LeomorBE/3DController/Schematique/dimensions_teensylc.png

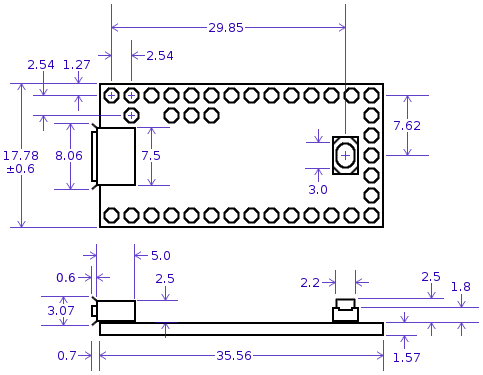
Schematique/dimensions_teensylc.png
