LeomorBE/3DController/Schematique/Proto/Proto-F_Cu.jpg

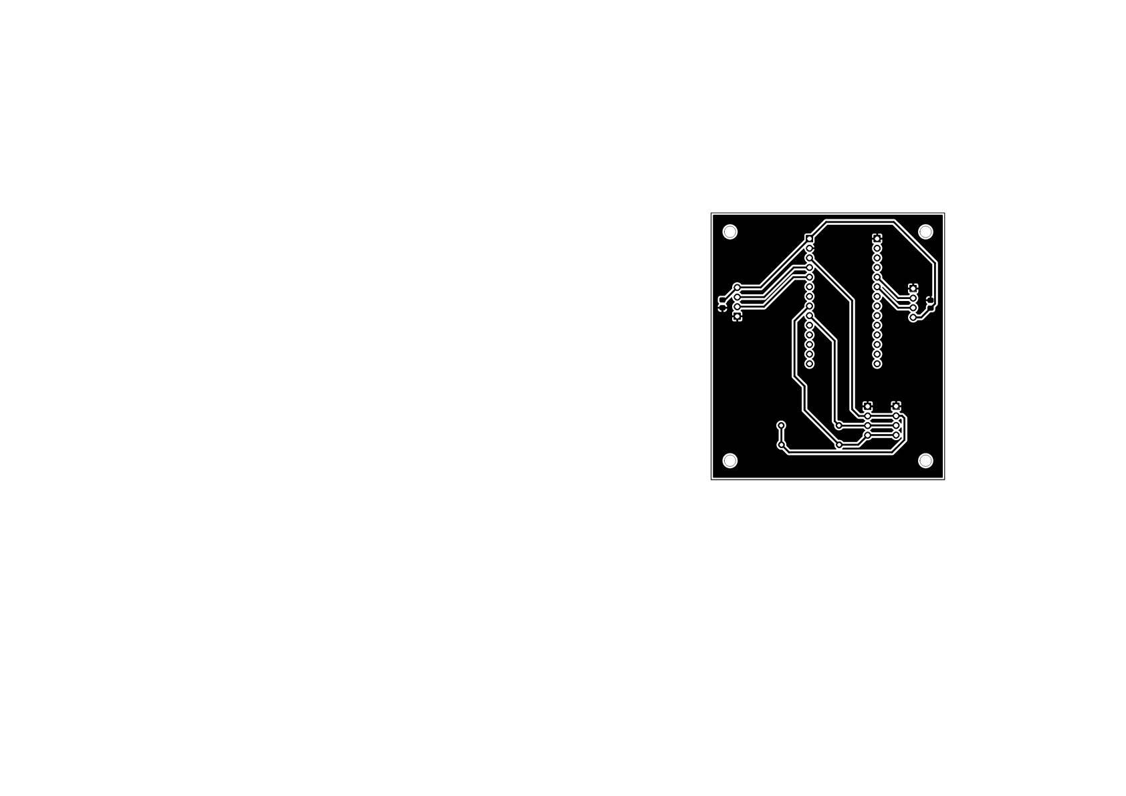
Schematique/Proto/Proto-F_Cu.jpg
