LeomorBE/3DController/manette.3mf

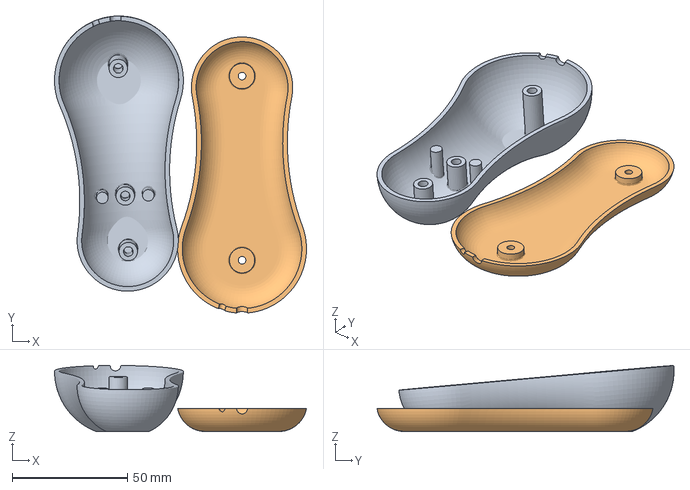
[picture p6: CAD file, 2026-11-09]
manette.3mf
109.5 x 129.0 x 28.7 mm
manette.stl
couvercle manette.stl
