LeomorBE/3DController/couvercle manette.stl

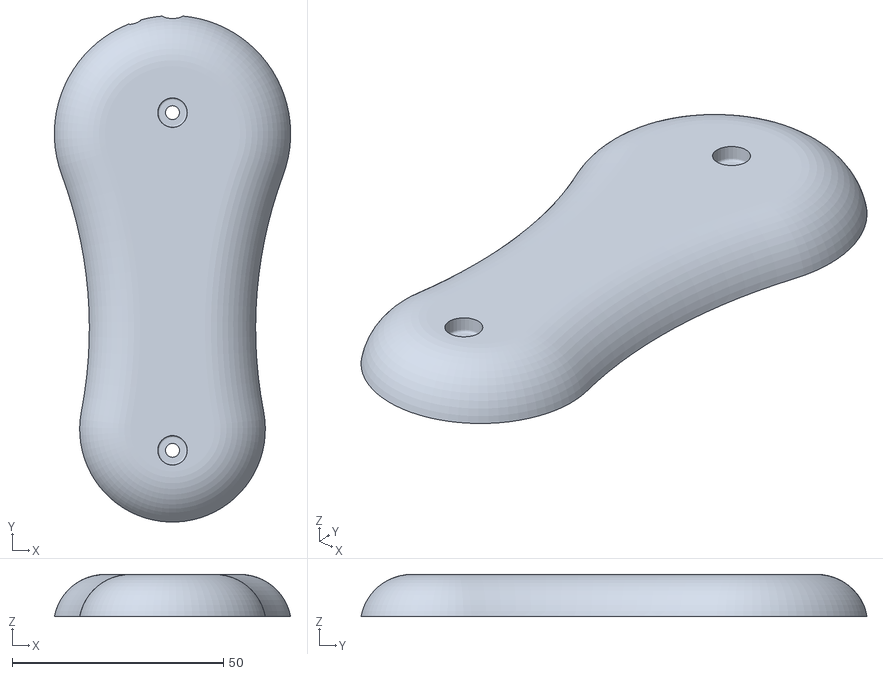
[picture p7: CAD file, 2026-11-09]
couvercle manette.stl
56.0 x 119.9 x 10.0
