LeomorBE/3DController/(list of files, cad)

Other CAD files:
manette.stl
