LeomorBE/3DController/Schematique/Proto/Proto-F_Cu.pdf

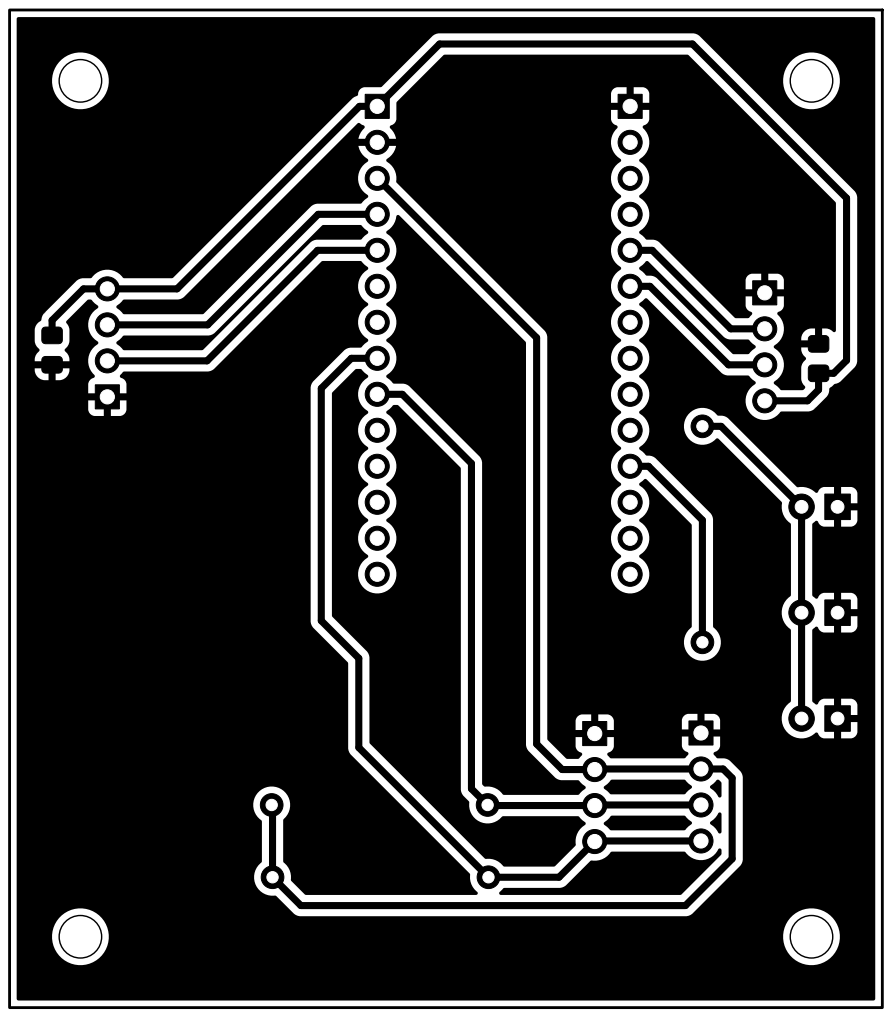
[picture p8: page 1]
