LeomorBE/3DController/Schematique/Proto/Proto-User_4.pdf

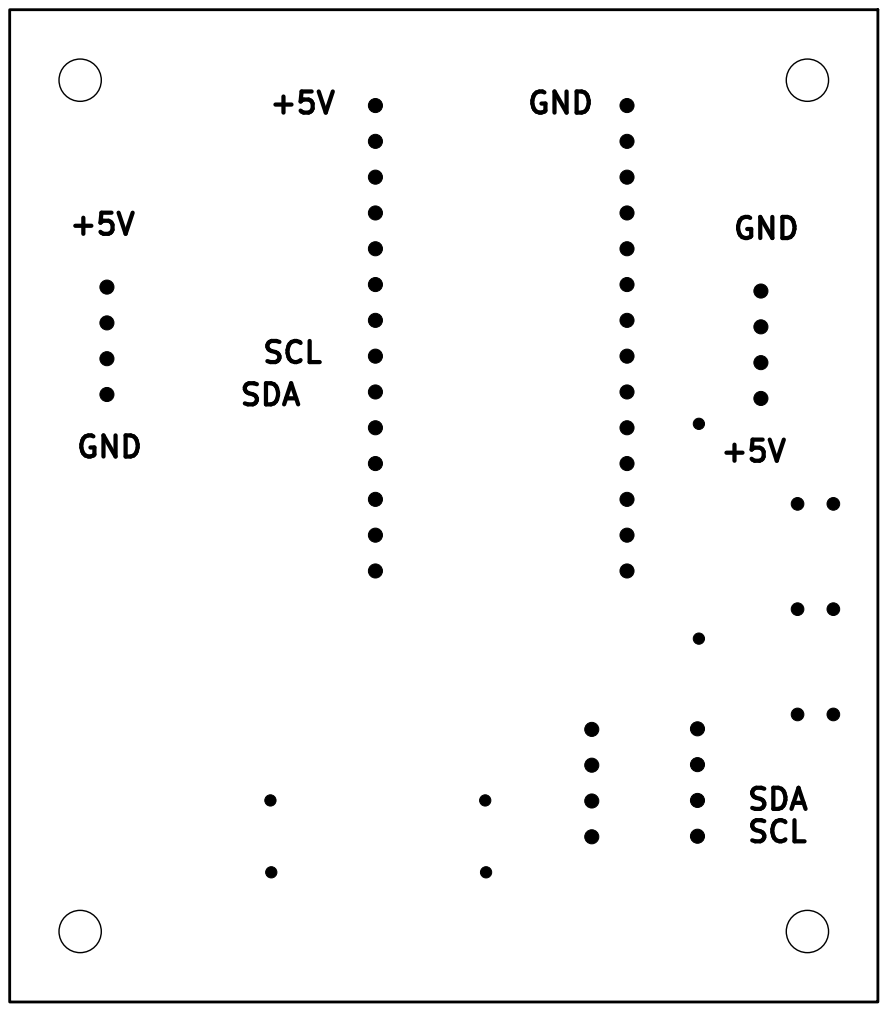
[picture p9: page 1]
