LeomorBE/3DController/Schematique/Proto/Proto.kicad_pcb

## KiCad design Schematique/Proto/Proto.kicad_pcb (2026-11-09)

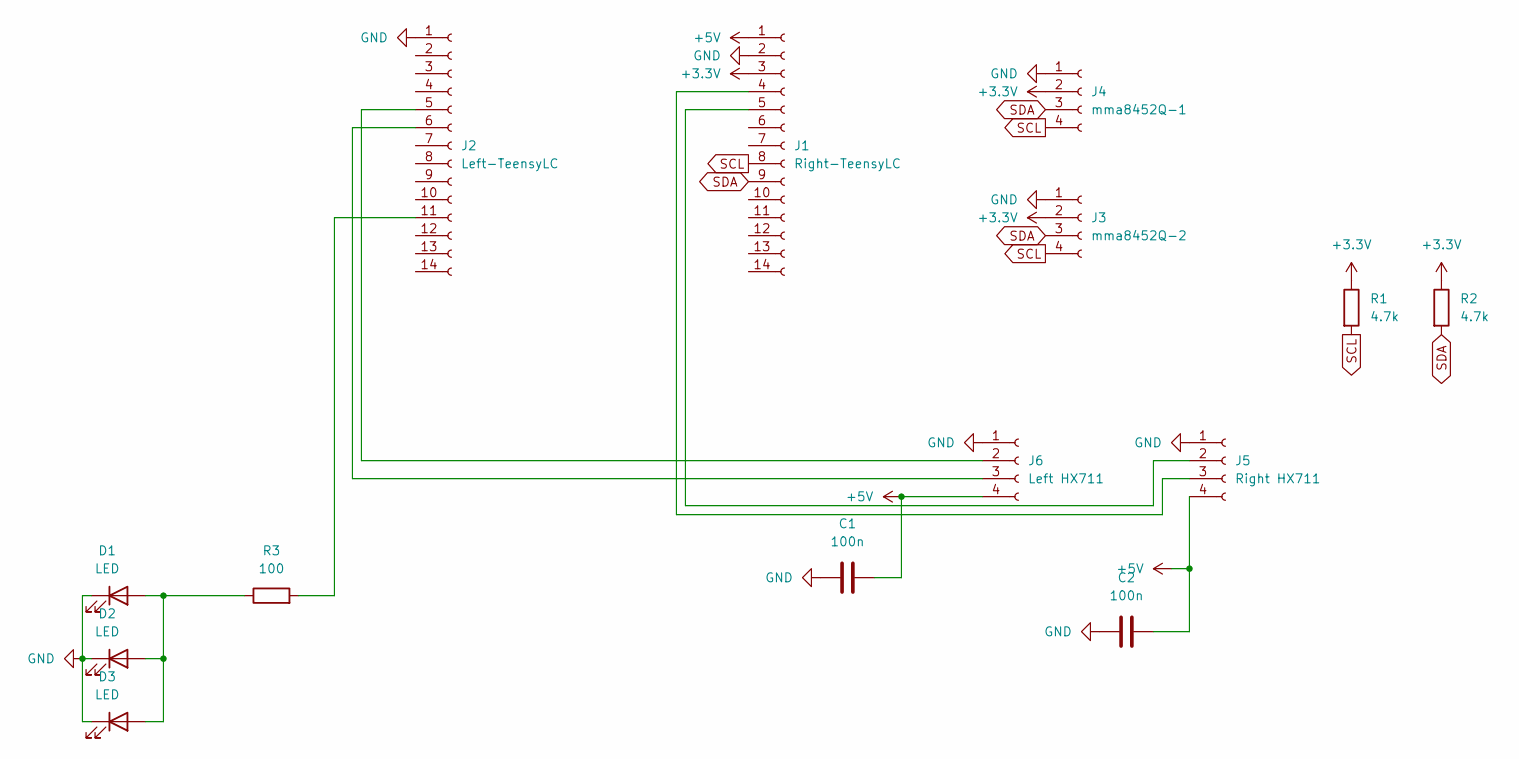
[picture p10: schematic Proto.kicad_sch]

Parts:
C1, C2: 100n; C_0805_2012Metric_Pad1.18x1.45mm_HandSolder
D1, D2, D3: LED; LED_D5.0mm
J1: Right-TeensyLC; PinHeader_1x14_P2.54mm_Vertical
J2: Left-TeensyLC; PinHeader_1x14_P2.54mm_Vertical
J3: mma8452Q-2; PinHeader_1x04_P2.54mm_Vertical
J4: mma8452Q-1; PinHeader_1x04_P2.54mm_Vertical
J5: Right HX711; PinHeader_1x04_P2.54mm_Vertical
J6: Left HX711; PinHeader_1x04_P2.54mm_Vertical
R1, R2: 4.7k; R_Axial_DIN0309_L9.0mm_D3.2mm_P15.24mm_Horizontal
R3: 100; R_Axial_DIN0309_L9.0mm_D3.2mm_P15.24mm_Horizontal

Connections:
+3.3V: J1.3, J3.2, J4.2, R1.1, R2.1
+5V: C1.2, C2.2, J1.1, J5.4, J6.4
GND: C1.1, C2.1, D1.1 (K), D2.1 (K), D3.1 (K), J1.2, J2.1, J3.1, J4.1, J5.1, J6.1
unnamed: D1.2 (A), D2.2 (A), D3.2 (A), R3.1
unnamed: J1.4, J5.3
unnamed: J1.5, J5.2
unnamed: J2.5, J6.2
unnamed: J2.6, J6.3
unnamed: J2.11, R3.2
SCL: J1.8, J3.4, J4.4, R1.2
SDA: J1.9, J3.3, J4.3, R2.2

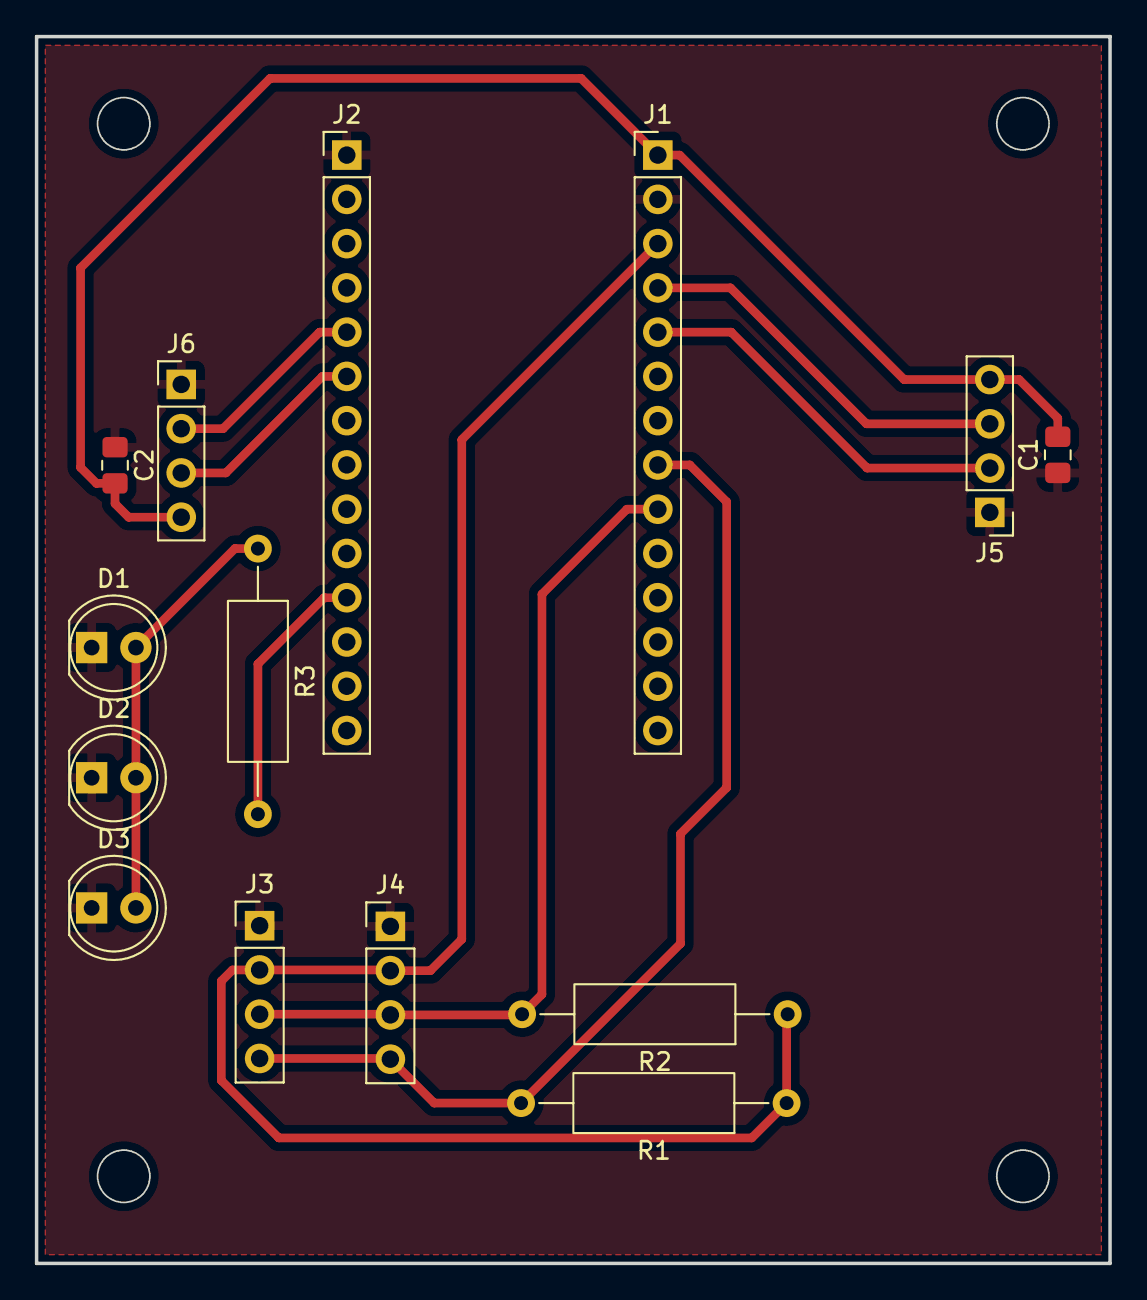
[picture p11: board Proto.kicad_pcb from above]

Board: 2 copper layers, 61.6 x 70.4 mm, 14 parts (0 on the bottom side), 11 nets.
