LeomorBE/3DController/Latex/Rapport de Probleme.pdf

Institut Supérieur

Industriel de Bruxelles

I.S.I.B.

HE2B - orientation ingénieur industriel en Électronique

1

ère Année Master

# Prototypage Analyse du problème

Auteur :
Leonardo Rafael Mora

Professeur :

G. Le Vaillant

3 novembre 2026

## Table des matières

1 Remise en contexte | 1
2 Explication du problème | 2
3 Solutions proposées | 3

## Table des figures

1 | Position des 3 axes | | 1
2 | Trame de données HID Joystick | | 2
3 | Trame de données HID Multi-axis Controller | | 3

Analyse du problème

## 1 Remise en contexte

Dans le cadre du cours, nous devons effectuer un projet qui consiste à l’élaboration de deux manettes gyro-scopique. Ces manettes utilisent un module d’acceleration 3DoF et un capteur de force chacune. Ils permettent donc l’envois de données suivantes :
— Pitch est la rotation autour de l’axe X (verticale).
— Roll est la rotation autour de l’axe Y (transversale).
— Weight est le poids ou la force.

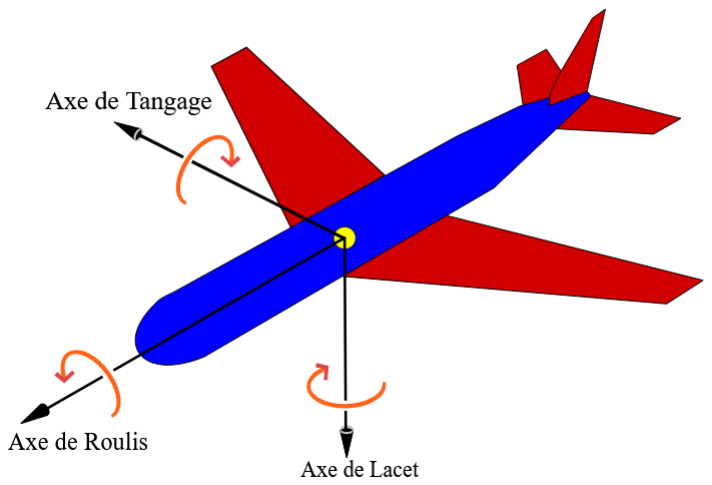
[picture p12: figure]

Figure 1 – Position des 3 axes

Pitch et Roll sont basés sur les données d’accélération du capteur MMA8452Q et Weight est basé sur le capteur HX711.
Les deux manettes utilisent un Teensy LC avec le protocole HID. Ce protocole permet d’échanger des informations à grande vitesse.
Ce protocole permet de définir l’utilisation du device, le contenu de chaque valeur ainsi que des informations supplémentaires.
Made with LATEX | 1 | 1

## 2 Explication du problème

Lors du codage du Teensy, nous avons utilisé le protocole HID pour Joystick. Il permet l’ajout de divers données dont les axes X, Y, Z et 2 sliders.

Figure 2 – Trame de données HID Joystick

Le problème se trouve dans le positionnement des données pour des mêmes types de données et la librairie de base de Unity permettant de les utiliser.
Une fois que nous avons configuré, nous avons testé les manettes avec un utilitaire de Windows afin de voir les données reçues et voir la bonne configuration du HID, nous avons également développer une vue avec 2 cube afin de voir les manettes en action, c’est à ce moment là que nous avons observé que les capteurs de forces mises dans les sliders avaient un problème, la librairie ne reconnaissait qu’un seul slider alors que deux étaient bien configurés.
Le problème déduit est le mauvais développement de la librairie (rudimentaire) de Unity, un problème se trouvant également sur Linux.
En général les développeurs utilisent les informations envoyé par le device pour ensuite extraire les données. Lors d’envoie de trames, une trame contenant une table descriptive du device et de ses entrées est envoyé en premier, et ensuite nous recevons/envoyons les données.
Made with LATEX | 2 | 2

## 3 Solutions proposées

Plusieurs solutions peuvent le contourner :
— Utiliser au lieu de deux sliders, l’entrée Rz et un slider.
Pour un développeur il pourrait croire que ce soit de vrai entrées X, Y, Z et Rz alors que ce sont des roll, pitch et force.
— Modifier une entrée de table HID par Dial, cette déclaration est utilisé notamment lors de problèmes de reonnaissance distinctes tels que les sliders sur Linux.
— Utiliser une configuration de Joystick avec plus d’entrées, et utiliser des entrées analogiques différentes au choix.
Pour un développeur, les données définies et les données reçues peuvent porter à confusion, de plus la trame sera beaucoup trop long car il y aura beaucoup plus d’entrées.
— Créer sa propre table HID avec des entrées spécifique à Roll, Pitch et Weight. Les données déclarées seront les vraies données reçues.
C’est plus compliqué à développer car nous devons définir la table HID et la fonction de trame à envoyer, mais elle respectera complètement les normes HID.
La solution actuellement étudiée est la création de sa propre table HID.
Elle sera basée sur cette trame là :

Figure 3 – Trame de données HID Multi-axis Controller

Nous nous basons sur le document HID Usage Tables for Universal Serial Bus (USB) de USB Implementers Forum, qui définit les normes de HID et nous utiliserons les différents ID pour créer notre table.

Name | Type | Usage ID [HEX]
Multi-axis Controller | Collection application | 0x08
Pitch Forward/Backward | Dynamic Value | 0x22
Roll Right/Left | Dynamic Value | 0x23
Data Weight | Dynamic Value | 0x40

Table 1 – Table HID Multi-axis Controller

Cela permettra d’utiliser une table selon les bonnes normes de HID. Si l’utilisation des Data weight cote à cote dans la trame pose problème, nous pouvons en remplacer une entrée par Data Scaling (0x41) afin de les différencier.

0. Collection Application permet de définir l’usage et les fonctions du device.
Made with LATEX | 3 | 3
