LeomorBE/3DController/(commit log)

2026-11-04 add projet
    [Proto.kicad_pcb, Proto.kicad_sch]
2026-11-09 add led button and modify layer unity
    [Proto.kicad_pcb, Proto.kicad_sch, couvercle manette.stl, manette.3mf, manette.stl]
